Andy0122/CE1107-Cerrojo-Logico/docs/Proyecto_FAC_Paper.pdf

INSTITUTO TECNOLOGICO DE COSTA RICA, CE 1107: FUNDAMENTOS DE ARQUITECTURA DE COMPUTADORES, SEPTIEMBRE 2026 | 1 ´
Diseno, Optimizaci ˜ | on e Implementaci ´ | on F ´ | ísica de

# un Cerrojo Digital en Base 5 con Disciplina

Estatica TTL y Desacople Galv ´ | anico ´

Juan Pablo Araya Rodríguez y Dylan Elizondo Picado

Resumen—This paper presents the design, algebraic minimization, and physical implementation of an electronic door locking system governed by three-digit base-5 passwords. The input interface acquires data through a four-finger photoresistor array conditioned by Schmitt-trigger inverters to suppress analog noise, followed by an optimized XOR parity and combinational encoding network yielding a three-bit binary representation. Data transmission adheres to a strict single-wire serial constraint achieved via a multiplexer driven by a synchronous modulo-3 counter. The receiving stage utilizes cascaded serial-in parallel-out shift registers to reconstruct the complete nine-bit parallel vector, alongside a secondary counter that asserts a completion flag. The combinational core validates the assigned passwords for opening and closing operations by applying De Morgan’s theorem to extract common literals, entirely eliminating discrete inverters. State retention is commanded by a discrete NOR-based SR latch, while status feedback is broadcast on a seven-segment display using intermediate one-hot decoding to render distinct operational characters. Furthermore, complete galvanic decoupling is realized through optical isolators driving an H-bridge motor controller with normally closed limit switches, preventing inductive transients from disturbing the TTL static discipline. Experimental evaluation validates deterministic switching, zero spurious latch transitions, and consistent mechanical actuation.

Index Terms—Circuitos combinacionales, logica secuencial, disciplina est ´ | atica TTL, desacople galv ´ | anico, Teorema de De Morgan. ´

✦

### 1. INTRODUCCION´

E
L diseno de sistemas de seguridad basados en l ˜ | ogica ´
digital discreta representa un pilar fundamental en la comprension de la arquitectura de computadores, per- ´ mitiendo la confluencia entre la síntesis combinatoria, la
sincronizacion secuencial y la interacci ´ | on con transductores ´
electromecanicos [1]. Tradicionalmente, los mecanismos de ´ autenticacion num ´ erica se conciben en esquemas decimales o ´ hexadecimales acoplados a microcontroladores; no obstante, el diseno estructurado a nivel de circuitos integrados de baja ˜
escala de integracion (SSI) y media escala de integraci ´ | on´
(MSI) demanda un analisis riguroso de la disciplina est ´ | atica, ´
retardos de propagacion y consumo de ´ | area en silicio [2], [4]. ´
El presente artículo documenta el desarrollo integral
de una cerradura electronica gobernada por contrase ´ | nas ˜
de tres dígitos en base 5 (0 . . . 4), ingresadas manualmente mediante el conteo de dedos extendidos. La especificacion´
tecnica establece restricciones de dise ´ | no cr ˜ | íticas: la interfaz
entre el bloque sensorial y el procesamiento digital debe ser
estrictamente serial (un unico conductor f ´ | ísico), el procesa-
miento combinatorio debe implementarse exclusivamente mediante circuitos integrados de compuertas logicas bajo ´
una unica familia tecnol ´ | ogica, y la etapa motriz debe aislarse ´
electricamente del n ´ | ucleo l ´ | ogico mediante componentes ´
discretos.
El objetivo central radica en sintetizar una arquitectura determinista que optimice el conteo de compuertas mediante

Los autores son estudiantes de la Escuela de Ingeniería en Computadores del Instituto Tecnológico de Costa Rica (TEC), Cartago, Costa Rica (emails: ju.araya@estudiantec.cr, delizondo@estudiantec.cr). Curso: CE 1107 — Fundamentos de Arquitectura de Computadores, II Semestre 2026. Profesor: Luis Chavarría Zamora.

tecnicas formales de reducci ´ | on booleana, erradique estados ´
indeterminados en la memoria de retencion y desacople ´ galvanicamente los transitorios de potencia generados por el ´ actuador de corriente directa.
El resto de este artículo se organiza de la siguiente manera: la Seccion II analiza los fundamentos de la disciplina ´
estatica bajo la uniformidad tecnol ´ | ogica TTL; la Secci ´ | on´
III detalla la metodología, el algoritmo de diseno modular ˜
y la reduccion de contrase ´ | nas; la Secci ˜ | on IV describe la ´
etapa de desacople de potencia y control de movimiento; la Seccion V expone los resultados experimentales y la ´ discusion de laboratorio; y las Secciones VI y VII presentan ´ las conclusiones y recomendaciones en prosa.
2. DISCIPLINA ESTATICA Y ´ | UNIFORMIDAD TEC-
NOLOGICA ´ | TTL
La disciplina estatica garantiza que una red l ´ | ogica man- ´
tenga una interpretacion inequ ´ | ívoca de los niveles booleanos
(0 y 1) en presencia de atenuaciones y perturbaciones de ruido, definiendo bandas de voltaje prohibidas entre las tensiones de entrada y salida [3].
2.1. Niveles Logicos y M ´ | argenes de Ruido ´
Para la familia TTL estandar (serie 74LS alimentada a ´ VCC = 5,0 V), los umbrales de conmutacion nominales ´ corresponden a:
VOH(mín) = 2,7 V, | VOL(máx) = 0,4 V | (1)
VIH(mín) = 2,0 V, | VIL(máx) = 0,8 V | (2)

INSTITUTO TECNOLOGICO DE COSTA RICA, CE 1107: FUNDAMENTOS DE ARQUITECTURA DE COMPUTADORES, SEPTIEMBRE 2026 | 2 ´
Esto define un margen de ruido en alto de NMH | =
VOH(mín) − VIH(mín) = 0,7 V y un margen en bajo de

NML = VIL(máx) − VOL(máx) = 0,4 V.
Para preservar estos margenes y evitar zonas de inde- ´
terminacion el ´ | ectrica, el proyecto adopt ´ | o una ´ | estricta uni-
formidad tecnol ógica, empleando exclusivamente circuitos integrados de la familia bipolar TTL Schottky (74LS) en todo el sistema digital, descartando la interconexion con ´ tecnologías heterogeneas. ´

### 3. ARQUITECTURA DEL SISTEMA Y ALGORITMO DE

DISENÕ
El sistema opera mediante una secuencia estructurada de
adquisicion, conversi ´ | on, transporte y validaci ´ | on, dividida en ´
cinco submodulos coordinados. ´

### 3.1. Modulo 1: Captura Sensorial y Codificador Combi- ´

natorio
El registro de los dedos se efectua mediante cuatro fotore- ´ sistencias (L3, L2, L1, L0) en divisor de tension con resisten- ´ cias pull-up de 10 kΩ. Dado que la transicion anal ´ ogica de luz ´ a sombra introduce retardos variables y ruido, se intercalo un ´ integrado inversor Schmitt Trigger ‘74LS14‘, cuya histeresis ´ interna regenera ondas cuadradas ideales de 0 V a 5 V. Cuatro LEDs indicadores proporcionan retroalimentacion visual en ´ paralelo.
Al asumir una colocacion termom ´ | etrica de los dedos ( ´ | 0 a
4), las 16 combinaciones teoricas se reducen a 5 estados v ´ | ali- ´
dos; los 11 estados restantes se modelaron como condiciones de no importa (X). Mediante analisis en Mapas de Karnaugh ´ de 4 variables:
Bit mas significativo ( ´ | D2): Activo solo en 4 dedos
(m15). Se sintetiza como D2 = L0 · L1 · L2 · L3 con una compuerta AND (‘74LS21‘).
Bit medio (D1): Activo en 2 y 3 dedos. Su lazo mínimo resulta en D1 = L1 · L3, implementado con un inversor y una compuerta AND (‘74LS08‘).
Bit menos significativo (D0): Activo en 1 y 3 dedos. Presenta un comportamiento de paridad impar, sintetizado elegantemente mediante un arbol de tres ´ compuertas XOR (‘74LS86‘):
D0 = (L0 ⊕ L1) ⊕ (L2 ⊕ L3) | (3)

### 3.2. Modulo 2: Serializador con CI TTL 74153 y Contador ´

Modulo-3 ´
Para canalizar el vector paralelo (D2D1D0) a traves´
de un unico canal serial, se implement ´ | | o un multiplexor ´
‘74LS153‘ [5]. Sus canales 1C0, 1C1, 1C2 reciben los bits de datos, mientras que 1C3 y el estrobo activo en bajo (1G) se derivaron a tierra permanente.
La seleccion de canal es gobernada por un contador ´ síncrono de dos bits (Q1Q0) truncado a ciclo modulo-3 ´ (00 → 01 → 10 → 00), construido con dos flip-flops tipo D (‘74LS74‘), una compuerta NOR y una compuerta AND:
| D0 = Q1 + Q0, | D1 = Q0 · Q1 | (4)

Al alcanzar el estado 10, una red combinatoria emite la bandera de acarreo ‘F inDigito‘.

3.3. Modulo 3: Reconstrucci ´ | | | | on Serial-Paralelo y Bande- ´
ra ‘Listo‘
En el receptor, la línea serial ingresa a dos registros de desplazamiento de 8 bits SIPO ‘74LS164‘ conectados en cascada [6]: la salida QH del primer chip alimenta la entrada serie del segundo, conformando un registro continuo de 9 bits (P8 . . . P0).
Un segundo contador modulo-3 independiente (‘74LS74‘), ´ excitado por la senal ‘ ˜ F inDigito‘, contabiliza los 3 dígitos transmitidos (3 × 3 = 9 pulsos). Al completarse la trama, conmuta la bandera de control Listo = 1, congelando el registro y habilitando la etapa de discriminacion de claves. ´
3.4. Modulo 4: Núcleo Combinatorio y Evaluaci ´ | on de ´
Contrasenas ˜
Las contrasenas no triviales asignadas al sistema corres- ˜
ponden a la combinacion de apertura ´ | 4135 y la de cierre 1425.
Al expresar ambos codigos en su representaci ´ | on binaria de ´
nueve bits (P8 . . . P0) estructurada a partir del vector serial reconstituido, se obtiene el siguiente desglose posicional:

Tabla 1
Identificacion posicional de literales comunes para contrase ´ | nas ˜
Operacion | Valor ´ | P8 | P7 | P6 | P5 | P4 | P3 | P2 | P1 | P0
Apertura | 4135 | 0 | 1 | 1 | 0 | 0 | 1 | 1 | 0 | 0
Cierre | 1425 | 0 | 1 | 0 | 1 | 0 | 0 | 0 | 0 | 1

A partir de la Tabla 1, las funciones canonicas iniciales ´
que evaluan la coincidencia estricta de cada contrase ´ | na se ˜
definen inicialmente de forma disgregada como:
Abririni = P8 · P7 · P6 · P5 · P4 · P3 · P2 · P1 · P0 | (5)
Cerrarini = P8 · P7 · P6 · P5 · P4 · P3 · P2 · P1 · P0 | (6)
Para optimizar los recursos logicos y evitar la duplicaci ´ | on´
de compuertas, se observa que ambas expresiones comparten
un patron com ´ | un en las posiciones ´ | P8, P7, P4 y P1. Extrayen-
do algebraicamente dicho factor comun´ COMUN, se agrupan los literales de la siguiente manera:
COMUN = P8 · P7 · P4 · P1 | (7)

Aplicando formalmente el Teorema de De Morgan sobre las variables negadas que componen este termino: ´

P8 · P4 · P1 = P8 + P4 + P1 | (8)

Esta identidad permite sintetizar el bloque compartido empleando una compuerta NOR de tres entradas (‘74LS27‘) conectada en cascada con una compuerta AND (‘74LS08‘), cuya expresion final optimizada corresponde a: ´
COMUN = (P8 + P4 + P1) · P7 | (9)

Finalmente, factorizando este termino compartido, las ´ ecuaciones mínimas que gobiernan las salidas de evaluacion´ del nucleo combinatorio se estructuran como: ´
Abrir = COMUN · (P6 · P5 · P3 · P2 · P0) | (10)
Cerrar = COMUN · (P6 · P5 · P3 · P2 · P0) | (11)

Este enfoque de diseno modular y factorizado absorbe ˜ los estados complementados dentro de compuertas NOR comerciales, erradicando por completo la necesidad de inversores discretos adicionales en el decodificador de claves.

INSTITUTO TECNOLOGICO DE COSTA RICA, CE 1107: FUNDAMENTOS DE ARQUITECTURA DE COMPUTADORES, SEPTIEMBRE 2026 | 3 ´

Tabla 2
Mapeo Logico de Segmentos para Visualizador de Anuncios ´
Estado | Caracter | Listo ´ | SA | SC | SE | a | b, c | d | g
Leyendo | L | 0 | 0 | 0 | 0 | 0 | 0 | 1 | 0
Abierta | A | 1 | 1 | 0 | 0 | 1 | 1 | 0 | 1
Cerrada | C | 1 | 0 | 1 | 0 | 1 | 0 | 1 | 0
Error | E | 1 | 0 | 0 | 1 | 1 | 0 | 1 | 1

### 3.5. Modulo 5: Memoria de Estado y Decodificador de ´

Anuncios
Las líneas discriminadas excitan un biestable Latch SR construido con dos compuertas NOR cruzadas (‘74LS02‘):
Qt+1 = R + Qt, | Qt+1 = S + Qt | (12)

Dado que las claves son mutuamente excluyentes, la condi-
cion cr ´ | ítica indeterminada (S = 1, R = 1) queda eliminada
matematicamente por dise ´ | no. ˜
El visualizador de 7 segmentos (catodo com ´ | un) despliega ´
el estado del cerrojo. Para optimizar la síntesis, se generaron tres estados intermedios en codigo *one-hot*: ´
SA = Abrir · Listo | (13)
SC = Cerrar · Listo | (14)
SE = (Abrir + Cerrar) · Listo | (15)

El mapeo de segmentos resultante se presenta en la Tabla 2. Los segmentos e y f permanecen conectados estaticamente ´ a VCC (constante 1), mientras que los segmentos restantes se deducen como: b = c = SA, d = SA, g = SA + SE y a = SA + SC + SE, empleando compuertas OR (‘74LS32‘) y una compuerta NOT (‘74LS04‘).

4. ETAPA DE DESACOPLE GALVANICO Y ´ | ACTUA-

DOR
Para satisfacer el requerimiento de aislar electricamente el ´
circuito logico del mecanismo electromec ´ | anico, se dise ´ | nõ una ´
etapa de potencia basada en optoacopladores y un puente H.

### 4.1. Aislamiento Optico mediante PC817 ´

Se interconectaron dos optoacopladores ‘PC817‘ entre la logica digital y el driver del motor. Las salidas del Latch ´ (Q y Q) excitan los diodos emisores infrarrojos a traves´ de resistencias de 330 Ω, demandando una corriente de
polarizacion segura de ´ | IF ≈ 11,5 mA. Los fototransistores
receptores operan acoplados al dominio de una batería externa de 9 V, garantizando independencia absoluta entre las tierras GND5V y GND9V .

### 4.2. Driver L9110S y Logica Activa en Bajo ´

El accionador consiste en un motorreductor de CD comandado por un puente H ‘L9110S‘. Las entradas de
control del modulo operan bajo l ´ | ogica activa en bajo (Active ´
LOW) debido a resistencias internas de elevacion hacia ´ | 9 V.
Los fototransistores de los optoacopladores conmutan a tierra de potencia (GND9V ):
Reposo: Ambas entradas a 9 V → Motor en freno estatico. ´

Apertura: Entrada A-1A a 0 V → Giro en sentido directo.
Cierre: Entrada A-1B a 0 V → Giro en sentido inverso.

### 4.3. Control de Fin de Recorrido mediante Contactos

NC

En los extremos mecanicos de la puerta se fijaron dos ´ microswitches de palanca (F CA y F CC ). Los terminales comun (‘COM‘) y normalmente cerrado (‘NC‘) se intercalaron ´ directamente en serie con la alimentacion del LED del ´ optoacoplador respectivo. Al impactar el tope físico, la
palanca abre el contacto mecanico, extinguiendo la radiaci ´ | on´
optica y desactivando el puente H en menos de ´ | 5 ms. La
alta friccion est ´ | atica interna del tren de engranes impide el ´
retroceso mecanico de la maqueta, eliminando oscilaciones ´ erroneas sin requerir circuitos biestables adicionales. ´

### 5. RESULTADOS EXPERIMENTALES Y DISCUSION´

El prototipo se implemento en protoboards totalizando ´ 15 circuitos integrados TTL de la serie 74LS, interconectados a una maqueta de puerta a escala.

5.1. Inmunidad y Validacion de Contrase ´ | nas ˜

Se aplico un banco de pruebas exhaustivo evaluando com- ´ binaciones nominales y vectores con distancia de Hamming igual a 1 bit respecto a las claves verdaderas (Tabla 3). En todos los casos de clave incorrecta o vectores degenerados (nulo o saturado), el sistema rechazo el ingreso de manera ´ determinista, activando el caracter ‘E‘ en el display sin alterar ´ el estado previo del Latch SR.

### 5.2. Filtrado Antirrebote y Desacoplo de Ruido

Durante las pruebas preliminares, los pulsadores manuales de reloj manifestaron transitorios mecanicos de conmuta- ´
cion (bounce), provocando saltos an ´ | omalos en los contadores ´
‘74LS74‘. La insercion de condensadores RC ( ´ | 10 kΩ y 10 µF,
τ = 100 ms) elimino completamente las falsas transiciones. ´
Asimismo, la segregacion galv ´ | anica mediante los op- ´
toacopladores ‘PC817‘ demostro una efectividad cr ´ | ítica,
comprobando que las corrientes inductivas de retorno fueron confinadas íntegramente en la batería de 9 V.

Tabla 3
Resultados de Validacion de Vectores de Entrada ´
Descripcion del Vector | Entrada ( ´ | P8 . . . P0) | Abrir | Cerrar | Display
Apertura Valida ( ´ | 4135) | 011001100 | 1 | 0 | A
Cierre Valido ( ´ | 1425) | 010100001 | 0 | 1 | C
Vector Nulo | 000000000 | 0 | 0 | E
Vector Saturado | 111111111 | 0 | 0 | E
Error 1 bit en Apertura | 011001101 | 0 | 0 | E
Error 1 bit en Cierre | 010100000 | 0 | 0 | E

INSTITUTO TECNOLOGICO DE COSTA RICA, CE 1107: FUNDAMENTOS DE ARQUITECTURA DE COMPUTADORES, SEPTIEMBRE 2026 | 4 ´

### 6. CONCLUSIONES

El diseno e implementaci ˜ | on del cerrojo digital en base 5 ´
demostro la viabilidad de sintetizar sistemas de autenticaci ´ | | on´
robustos empleando exclusivamente logica cableada discreta ´ y circuitos integrados estandar de la familia TTL Schottky. La ´ descomposicion modular de la interfaz serial, materializada ´ mediante el multiplexor 74LS153 y contadores síncronos
de dos bits, permitio superar con ´ | exito la restricci ´ | on de ´
canal unico de comunicaci ´ | on, reconstruyendo de forma ´
determinista el bus paralelo de nueve variables a traves´ de registros de desplazamiento en cascada.
La aplicacion sistem ´ | atica del Teorema de De Morgan en el ´
decodificador de contrasenas evidenci ˜ | o ser una estrategia de ´
optimizacion sumamente eficaz, posibilitando la extracci ´ | | on´
de un termino com ´ | un para las claves de apertura y cierre y ´
la absorcion de los estados complementados dentro de com- ´ puertas NOR comerciales, lo cual erradico por completo la ´ necesidad de inversores discretos en dicha etapa. Asimismo,
la estructuracion de variables intermedias bajo codificaci ´ | | on´
one-hot desacoplo la complejidad anal ´ | ítica del visualizador
de anuncios, minimizando el conteo de compuertas y permi-
tiendo polarizar estaticamente dos segmentos a la l ´ | | ínea de
alimentacion. ´
Finalmente, la integracion de una etapa de desacople ´ galvanico fundamentada en optoacopladores y el aprove- ´ chamiento de los contactos normalmente cerrados de los finales de carrera demostraron ser determinantes para la
estabilidad electromecanica. Esta arquitectura no solo aisl ´ | | ó
las perturbaciones inductivas y rebotes de tierra propios del
motorreductor preservando la disciplina estatica del n ´ | ucleo ´
digital, sino que garantizo una detenci ´ | on f ´ | ísica inmediata de
la puerta sin requerir memorias secuenciales auxiliares.

### 7. RECOMENDACIONES

Para desarrollos futuros y extensiones industriales de este proyecto, se aconseja incorporar redes de disparo Schmitt Trigger integradas directamente en cada una de las líneas de reloj y reinicio maestro, sustituyendo los filtros RC pasivos por conformadores de pulso activos con el proposito de ´ optimizar los tiempos de subida y bajada ante frecuencias de conmutacion m ´ as elevadas. ´
Asimismo, se recomienda sustituir el modulo de fotore- ´ sistencias dependiente de la luz ambiental por transductores opticos infrarrojos de barrera ranurada o interruptores ´ capacitivos blindados, lo cual reduciría la necesidad de cali-
bracion resistiva y asegurar ´ | | ía un funcionamiento uniforme
bajo cualquier condicion de iluminaci ´ | on en el entorno de ´
operacion. ´
En lo concerniente al montaje físico de alta densidad en protoboard, se sugiere tender pistas de desacople de alimenta-
cion malladas acompa ´ | nadas de condensadores cer ˜ | amicos de ´
cien nanofaradios soldados directamente entre los terminales de polarizacion de cada circuito integrado, mitigando induc- ´
tancias parasitas asociadas a conductores a ´ | ereos extensos. ´
Por ultimo, resulta altamente conveniente dotar a la maqueta ´ de un embrague mecanico o fusible rearmable en serie con el ´ motor, salvaguardando la integridad del tren reductor ante eventuales fallas mecanicas en los microswitches de fin de ´ recorrido.

REFERENCIAS

[1] M. M. Mano y M. D. Ciletti, Digital Design: With an Introduction to the Verilog HDL, 5th ed. Boston, MA, USA: Pearson, 2013.
[2] S. L. Harris y D. Harris, Digital Design and Computer Architecture: ARM Edition. Cambridge, MA, USA: Morgan Kaufmann, 2022.
[3] T. L. Floyd, Fundamentos de Sistemas Digitales, 11th ed. Madrid,
Espana: Pearson Educaci ˜ | on, 2015. ´
[4] R. J. Tocci, N. S. Widmer, y G. L. Moss, Sistemas Digitales: Principios y Aplicaciones, 12th ed. Mexico: Pearson, 2017. ´
[5] Texas Instruments, SN74LS153 Dual 4-Line to 1-Line Data Selectors/Multiplexers Datasheet, Dallas, TX, USA, 2018.
[6] Texas Instruments, SN74LS164 8-Bit Parallel-Out Serial Shift Registers Datasheet, Dallas, TX, USA, 2020.
