Andy0122/CE1107-Cerrojo-Logico/docs/Bitácora_Proyecto_FAC.pdf

## Instituto Tecnológico de Costa Rica

Escuela de Ingeniería en Computadores CE 1107 Fundamentos de Arquitectura de Computadores

## Bitácora del Cerrojo Digital TTL

Diseño, Reducción Booleana, Módulos en Cascada, Aislamiento y Pruebas Experimentales

Estudiantes:
Juan Pablo Araya Rodríguez Dylan Elizondo Picado
Profesor: Luis Chavarría Zamora

Septiembre de 2026

### 1. Introducción y Alcance del Proyecto

La presente bitácora documenta de manera formal el desarrollo integral del sistema de cerrojo digital basado en lógica combinacional y secuencial TTL. El proyecto abarca desde la captura sensorial de la contraseña en base 5, pasando por el diseño de bloques en cascada, la reducción booleana por el teorema de De Morgan, hasta el control de potencia de un motor de corriente directa con aislamiento galvánico y visualización avanzada.

### 2. Arquitectura del Sistema y Conexión en Cascada

El flujo general de control se compone de módulos interconectados que procesan los estados de entrada y retención.

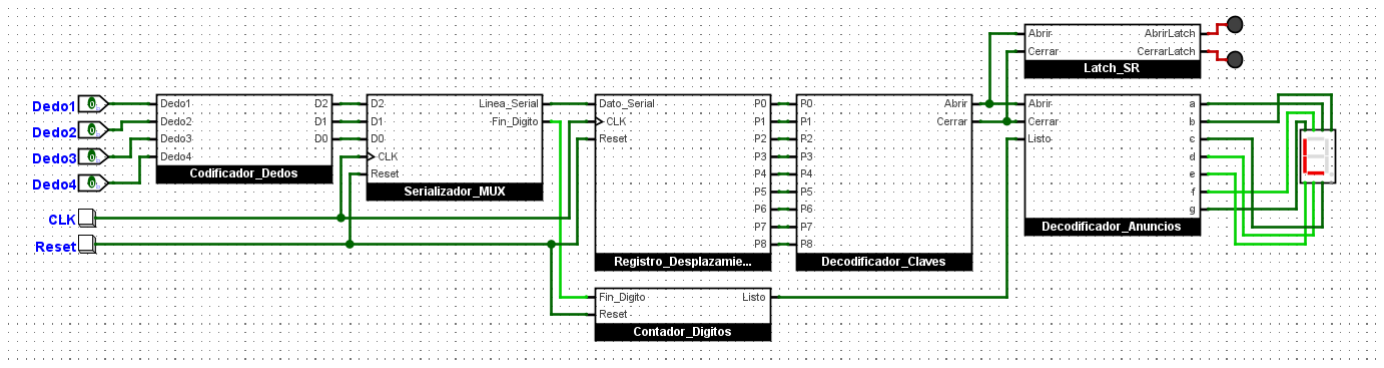
[picture p1: figure]

Figura 1: Diagrama de bloques y conexionado en cascada.

El Módulo 1 recibe los 9 bits estáticos (P8 . . . P0) correspondientes a la contraseña y genera las señales discriminadas Abrir y Cerrar. Estas alimentan en cascada al Módulo 2 (Latch de retención) y convergen junto con la señal de control Listo en el decodificador del visualizador.

### 3. Día 1 (18 de septiembre de 2026): Captura Sensorial y Codificación a Base 5

### 3.1. Modelo Sensorial

La contraseña se captura mediante una matriz de 4 fotoresistencias (LDRs, L0 . . . L3) dispuestas en divisores de tensión con resistencias pull-up de 10 kΩ. El conteo manual de dedos (0 a 4) presenta una naturaleza acumulativa. Se incorporaron LEDs con resistencias de 330 Ω para la validación visual de la postura de la mano.

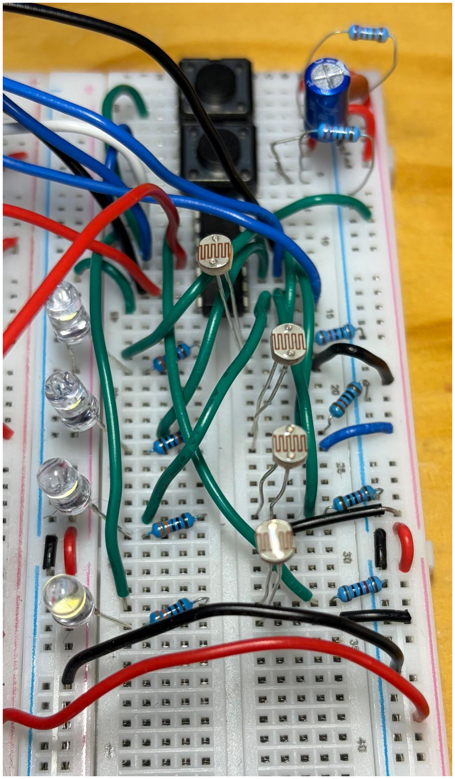
[picture p2: figure]

Figura 2: Circuito de LDRs.

### 3.2. Mapeo Sensorial y Deducción Algebraica

La traducción del vector sensorial (L3L2L1L0) al código binario natural (D2D1D0) se estructuró conforme a la Tabla 1. Las claves asignadas al sistema son:

Apertura (413 5): Dígito 4 (100), Dígito 1 (001), Dígito 3 (011) ⇒ 011 001 1002.

Cierre (142 5): Dígito 1 (001), Dígito 4 (100), Dígito 2 (010) ⇒ 010 100 0012.

Dedos | Estado LDR (L 3L 2L 1L 0) Decimal | Binario (D 2D 1D 0)
0 dedos | 0000 | 0 | 00 | 0
1 dedo | 0001 | 1 | 00 | 1
2 dedos | 0011 | 2 | 01 | 0
3 dedos | 0111 | 3 | 01 | 1
4 dedos | 1111 | 4 | 10 | 0

Tabla 1: Tabla de verdad del mapeo sensorial y codificación a 3 bits.

Las funciones lógicas del mapeo se dedujeron algebraicamente de la siguiente manera:

Bit Menos Significativo (D 0): Arbol de tres compuertas XOR (‘74LS86‘) como detector de ´ paridad impar: D0 = (L0 ⊕ L1) ⊕ (L2 ⊕ L3).

Bit Medio (D 1): Inhibición por L3 sobre L1: D1 = L1 · L3 (1 inversor ‘74LS04‘ y 1 compuerta AND ‘74LS08‘).

Bit Más Significativo (D 2): Conjunción total para el valor 4: D2 = L0 · L1 · L2 · L3 mediante compuerta AND de 4 entradas (‘74LS21‘).

### 4. Día 2 (19 de septiembre de 2026): Interfaz Serial, MUX 74153 y Contador Módulo-3

### 4.1. Multiplexación Serial y Contador Síncrono

Para convertir los 3 bits paralelos del dígito (D2D1D0) a un canal serial, se implementó el circuito integrado TTL ‘74LS153‘ (Doble MUX de 4 a 1 líneas). El Pin 1 (1G) se conectó a GND y el Pin 3 (1C3) a GND para evitar entradas flotantes. El indexador se construyó mediante un contador síncrono con dos flip-flops tipo D (‘74LS74‘), recorriendo la secuencia 00 → 01 → 10 → 00. Sus ecuaciones de realimentación son:

D0 = Q1 + Q2 (puerta NOR), | D1 = Q0 · Q1 (puerta AND) | (1)

garantizando auto-recuperación ante transitorios en el estado ilegal ‘11‘.

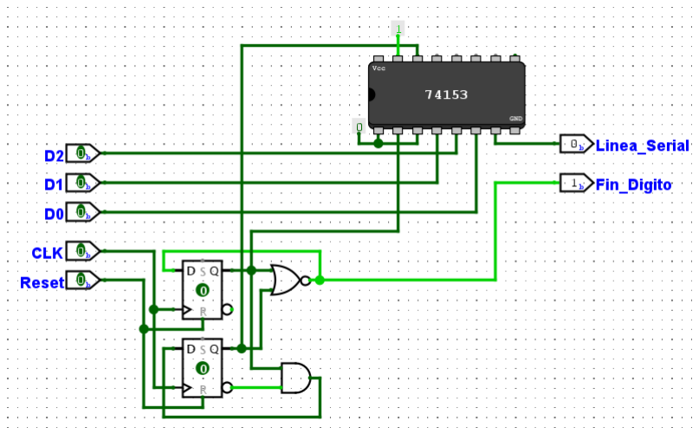
[picture p3: figure]

Figura 3: Diagrama esquemático del multiplexor 74LS153 y contador síncrono de control.

### 5. Día 3 (21 de septiembre de 2026): Registro SIPO de 9 Bits y Unidad de Control

### 5.1. Almacenamiento y Generación de Bandera

Los tres dígitos ingresados secuencialmente se almacenan en una cadena de registros de desplazamiento de entrada serial y salida paralela (SIPO) de 9 bits (P8 . . . P0). Un segundo contador módulo-3 incrementa su cuenta al finalizar cada dígito completo hasta activar la señal de control:

Listo = 1 | (2)

la cual notifica al decodificador de anuncios el fin de la lectura.

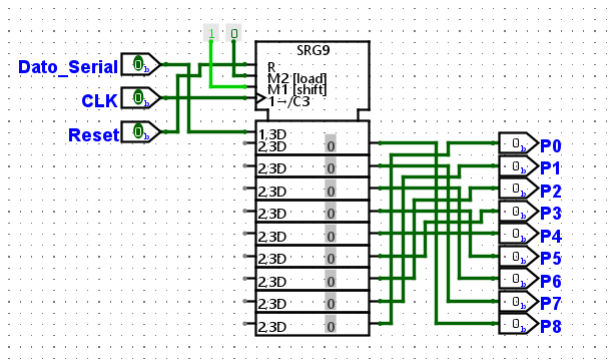
[picture p4: figure]

Figura 4: Implementación del registro SIPO de 9 bits.

### 6. Día 4 (23 de septiembre de 2026): Optimización Booleana y Desacople Galvánico

### 6.1. Reducción por Teorema de De Morgan

Las funciones lógicas canónicas del comparador requerirían dos redes independientes de 9 variables:

Abrir = P8 · P7 · P6 · P5 · P4 · P3 · P2 · P1 · P0 | (3)
Cerrar = P8 · P7 · P6 · P5 · P4 · P3 · P2 · P1 · P0 | (4)

Comparando el vector de apertura y el de cierre se extrajo el factor común:

COMUN = P8 · P7 · P4 · P1 = P8 + P4 + P1 · P7 | (5)

implementado con una compuerta NOR de 3 entradas (‘74LS27‘) y una AND (‘74LS08‘). Aplicando sistemáticamente el teorema de De Morgan, se eliminaron en su totalidad los 11 inversores requeridos por la forma canónica. Las expresiones mínimas quedan definidas como:

Abrir = COMUN · (P6 · P5 · P3 · P2 · P0) | (6)
Cerrar = COMUN · (P6 · P5 · P3 · P2 · P0) | (7)

### 6.2. Aislamiento Galvánico y Potencia

Para proteger los circuitos TTL (IOH ≈ 0,4 mA) del consumo transitorio del motor de CD (150 − 400 mA), se implementó aislamiento óptico con optoacopladores ‘PC817‘. La resistencia limitadora del LED emisor se fijó en 330 Ω (IF ≈ 11,51 mA). Las entradas del puente H ‘L9110S‘ se controlaron mediante los fototransistores en configuración pull-down directo.

### 6.3. Decodificador de Anuncios y Estados Intermedios

Para el display de 7 segmentos, se definieron tres variables de estado intermedio tipo one-hot (SA, SC, SE):

SA = Listo · Abrir · Cerrar | (8)
SC = Listo · Abrir · Cerrar | (9)
SE = Listo · Abrir + Cerrar | (10)

Reduciendo las funciones de segmentos, se obtiene que e = 1 (VDD) y f = 1 (VDD) de forma directa.

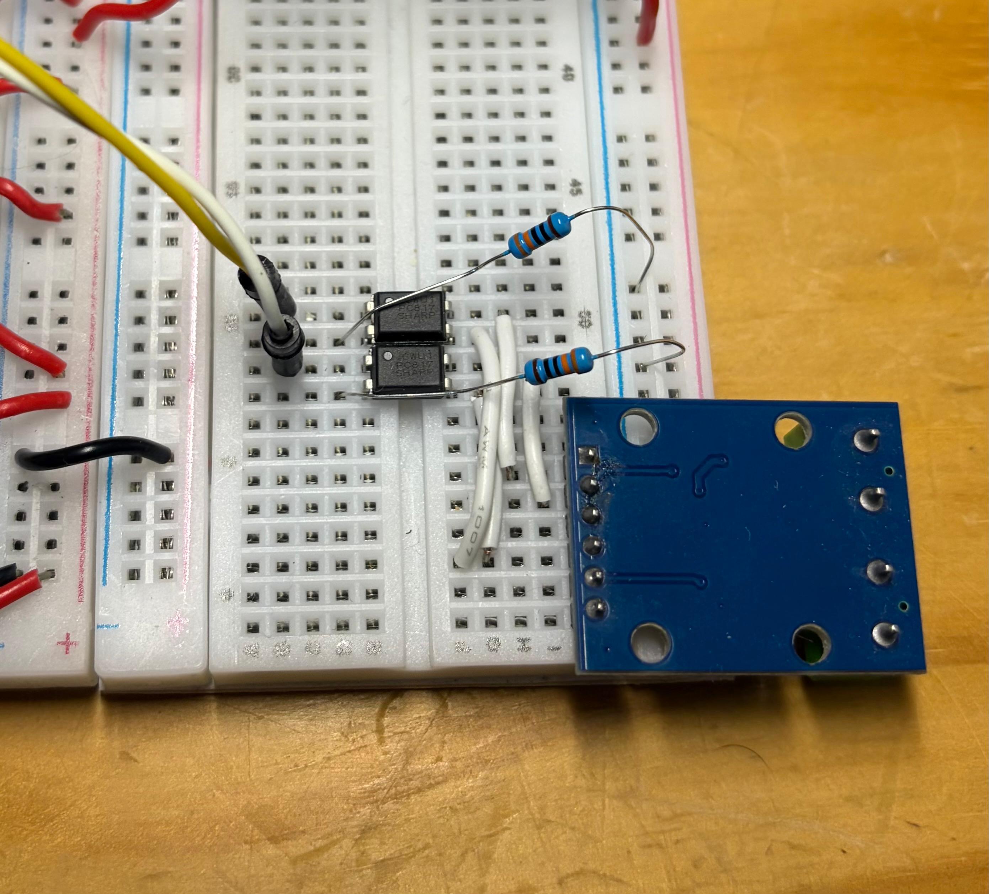
[picture p5: figure]

Figura 5: Circuito de aislamiento galvánico con optoacopladores y puente H.

### 7. Día 5 (25 de septiembre de 2026): Finales de Carrera y Pruebas Experimentales

### 7.1. Integración Electromecánica

Se intercalaron microswitches en configuración NC (Normalmente Cerrada) en serie con las líneas de los optoacopladores para cortar instantáneamente el motor al impactar los topes físicos F CA y F CC. Asimismo, se instaló un filtro antirrebote RC (R = 10 kΩ, C = 10 µF, τ = 100 ms) en los pulsadores de reloj y reset.

### 7.2. Validación Experimental y Pruebas en Cascada

Se evaluó el sistema completo frente a vectores válidos, nulos, saturados y errores de 1 bit (distancia
de Hamming), confirmando la robustez del diseño.
Condición de Prueba | Entrada (P 8 . . . P 0) Listo | Abrir | Cerrar | Display | Resultado Observado
Clave Apertura Válida | 011001100 | 1 | 1 | 0 | A | Apertura exitosa
Clave Cierre Válida | 010100001 | 1 | 0 | 1 | C | Cierre exitoso
Vector Nulo | 000000000 | 1 | 0 | 0 | E | Rechazo (Inválida)
Error de 1 bit | 011001101 | 1 | 0 | 0 | E | Rechazo absoluto

Tabla 2: Protocolo de pruebas experimentales integradas del sistema.

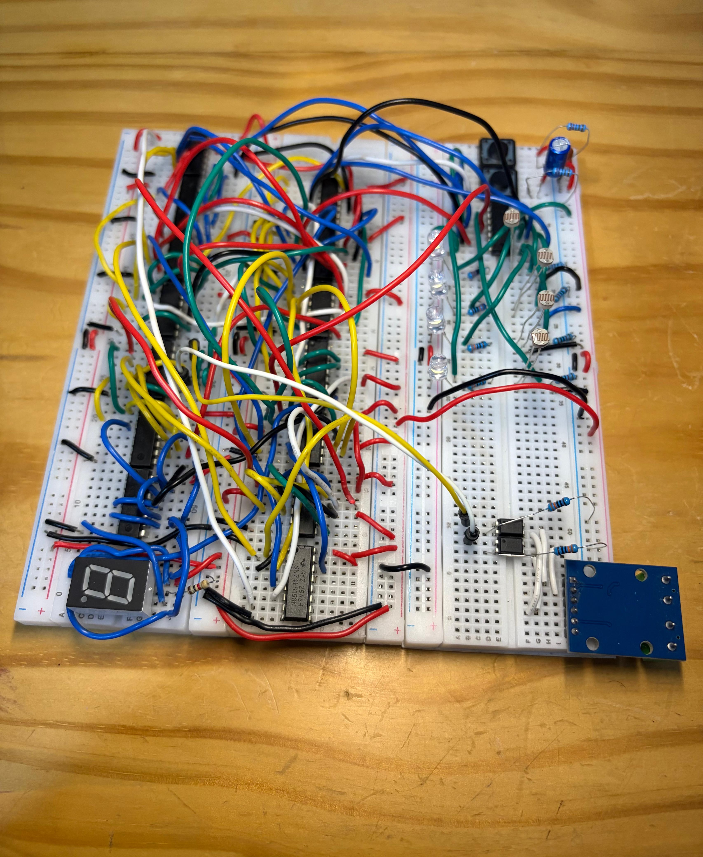
[picture p6: figure]

Figura 6: Montaje final integrado en protoboard.

### 8. Conclusiones

1. La extracción algebraica del término común mediante De Morgan optimizó sustancialmente la red combinacional del comparador de contraseñas.
2. La exclusión de la condición indeterminada (S = 1, R = 1) en el Latch SR se garantizó de forma natural debido a la mutua exclusión de las claves en base 5.
3. El uso de optoacopladores ‘PC817‘ previno eficazmente el ruido inductivo (ground bounce) generado por la conmutación del motor de corriente directa.
4. El seguimiento riguroso de las 5 sesiones de trabajo aseguró una implementación modular y verifi-cable tanto por bloques independientes como en cascada en protoboard.

### 9. Enlace al Repositorio de GitHub

El código fuente de los diagramas de Logisim Evolution, simulaciones y la documentación completa en LaTeX se encuentran disponibles de manera pública en el repositorio oficial del proyecto:

https://github.com/Andy0122/CE1107-Cerrojo-Logico
