Andy0122/CE1107-Cerrojo-Logico/docs/Bitacora_Taller_Semana5.pdf

## Instituto Tecnológico de Costa Rica

Escuela de Ingeniería en Computadores CE 1107 — Fundamentos de Arquitectura de Computadores

## Bitácora de Diseño: Sesión Asincrónica Semana 5

Implementación y Reducción de Etapas Combinacionales y Secuenciales (Prueba Estática)

Estudiantes:
Juan Pablo Araya Rodríguez Dylan Elizondo Picado
Profesor: Luis Chavarría Zamora

17 de septiembre de 2026

### 1. Objetivo y Alcance del Taller

El objetivo de esta sesión práctica es diseñar, simplificar algebraicamente e implementar mediante compuertas lógicas dos etapas fundamentales del sistema de seguridad:

1. Módulo de Contraseñas: Ingreso estático mediante interruptores de una clave en base 5 y visua-lización de estados en un display de siete segmentos.
2. Decodificador de Apertura y Cierre: Conectado en cascada desde las salidas del módulo anterior para comandar la memoria de estado de la puerta.

Para cumplir con la directriz de evaluación aislada, la presente bitácora documenta el diseño, la reducción booleana y la verificación experimental de cada bloque de forma independiente antes de su interconexión definitiva.
—

### 2. Arquitectura del Sistema y Conexión en Cascada

La Figura 1 describe el flujo de señales. El Módulo 1 recibe los 9 bits estáticos (P8 . . . P0) correspon-dientes a la contraseña y genera las señales discriminadas Abrir y Cerrar. Estas alimentan en cascada al Módulo 2 (Latch de retención) y convergen junto con la señal de control Listo en el decodificador del

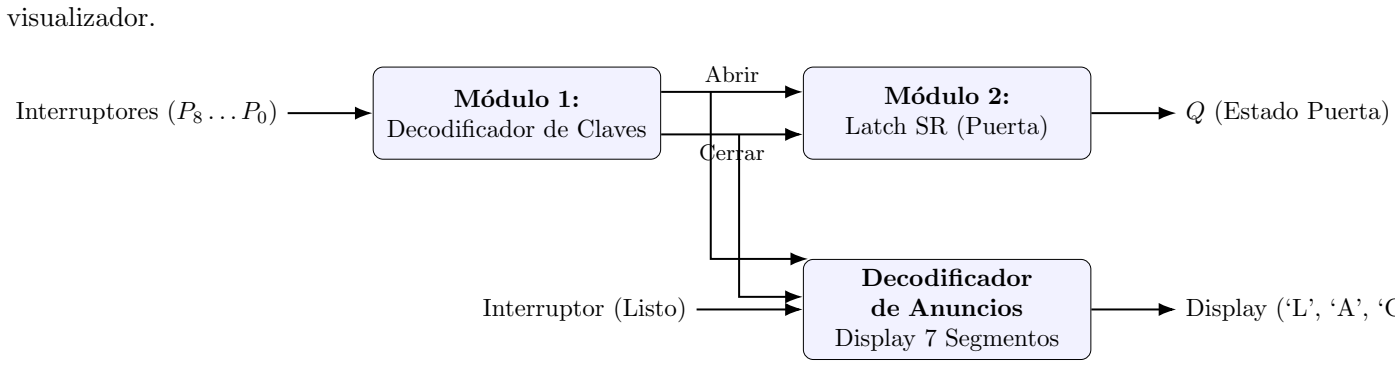
[picture p7: figure]
visualizador.; Interruptores (P8 . . . P0); Módulo 1:; Decodificador de Claves; Módulo 2: Latch SR (Puerta); Decodificador de Anuncios Display 7 Segmentos; Interruptor (Listo); Q (Estado Puerta); Display (‘L’, ‘A’, ‘C’, ‘E’); Abrir; Cerrar

Figura 1: Diagrama de bloques funcional y conexionado en cascada.

—

### 3. Módulo 1: Decodificador de Contraseñas (Diseño y Reducción)

### 3.1. Codificación de Claves en Base 5

Las contraseñas se componen de 3 dígitos en base 5 (0 . . . 4), donde cada dígito se codifica en 3 bits binarios (P2P1P0). Las claves asignadas al sistema son:

Apertura (4135): Dígito 4 (100), Dígito 1 (001), Dígito 3 (011) =⇒ 011 001 1002.

Cierre (1425): Dígito 1 (001), Dígito 4 (100), Dígito 2 (010) =⇒ 010 100 0012.

### 3.2. Deducción Booleana y Reducción por Término Común

Las funciones lógicas canónicas requerirían dos redes independientes de 9 variables:

Abrir = P8 · P7 · P6 · P5 · P4 · P3 · P2 · P1 · P0 | (1)
Cerrar = P8 · P7 · P6 · P5 · P4 · P3 · P2 · P1 · P0 | (2)

La Tabla 1 analiza la correlación posicional entre ambas funciones para extraer redundancias lógicas:

Variable | P8 | P7 | P6 | P5 | P4 | P3 | P2 | P1 | P0
Abrir | 0 | 1 | 1 | 0 | 0 | 1 | 1 | 0 | 0
Cerrar | 0 | 1 | 0 | 1 | 0 | 0 | 0 | 0 | 1
Coincidencia | 0 | 1 | ̸= | ̸= | 0 | ̸= | ̸= | 0 | ̸=

Tabla 1: Identificación posicional de literales comunes.

Se extrae el factor común algebraico denominado COMUN:

COMUN = P8 · P4 · P1 · P7 | (3)

Aplicando el teorema de De Morgan sobre las variables complementadas:

P8 · P4 · P1 = P8 + P4 + P1 | (4)

Esta reducción permite sintetizar el término común empleando una compuerta NOR de tres entradas conectada a una compuerta AND:

COMUN = (P8 + P4 + P1) · P7 | (5)

Las expresiones mínimas que gobiernan las salidas del decodificador son:

Abrir = COMUN · (P6 · P5 · P3 · P2 · P0) | (6)
Cerrar = COMUN · (P6 · P5 · P3 · P2 · P0) | (7)

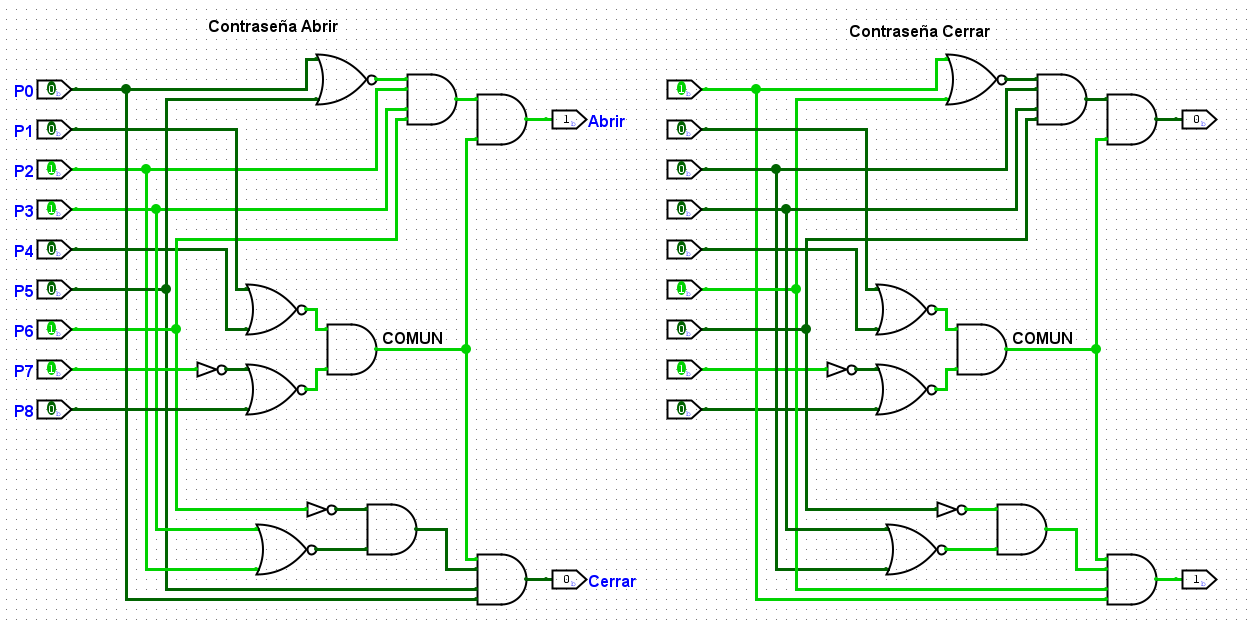
[picture p8: figure]

Figura 2: Esquemático del decodificador de claves optimizado.

### 4. Módulo 2: Decodificador de Apertura/Cierre y Retención (En Cascada)

### 4.1. Estructura del Latch SR

Las líneas Abrir y Cerrar generadas por el Módulo 1 se introducen en cascada a un Latch SR construido con compuertas NOR discretas:

Qt+1 = R + Qt

, | Qt+1 = S + Qt | (8)

Donde la señal Abrir excita la entrada Set (S) y la señal Cerrar excita la entrada Reset (R).

### 4.2. Exclusión de la Condición Crítica Indeterminada

La condición S = 1 y R = 1 representa el estado no permitido de un Latch SR. En esta arquitectura, **dicha condición queda excluida a nivel de diseño lógico**, dado que las combinaciones requeridas para activar Abrir (4135) y Cerrar (1425) son mutuamente excluyentes; no existe vector en las entradas P8 . . . P0 que satisfaga simultáneamente ambas ecuaciones booleanas.

S (Abrir) R (Cerrar) Qt+1 | Estado de la Puerta
0 | 0 | Qt | Retención de estado (Memoria)
1 | 0 | 1 | Puerta Abierta
0 | 1 | 0 | Puerta Cerrada
1 | 1 | — | Condición excluida por mutua exclusión de claves

Tabla 2: Tabla de transiciones del módulo de retención.

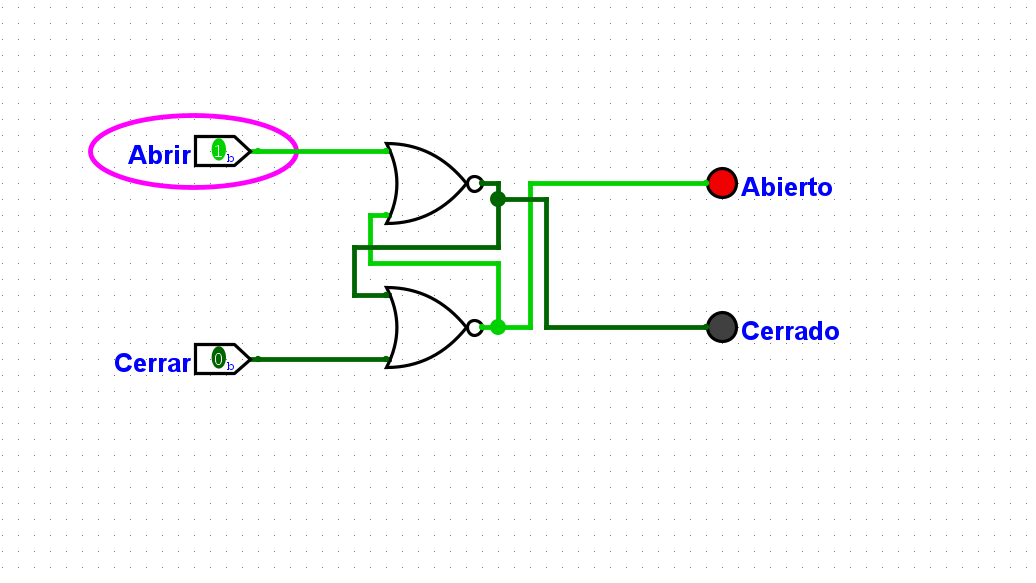
[picture p9: figure]

Figura 3: Implementación del circuito de retención.

### 5. Módulo 3: Decodificador de Anuncios (Display 7 Segmentos)

### 5.1. Tabla de Verdad y Estados Intermedios

El sistema traduce el estado de lectura y validación en cuatro caracteres intuitivos sobre un visualizador de cátodo común:

Leyendo (‘L’): Listo = 0.

Abriendo (‘A’): Listo = 1, Abrir = 1, Cerrar = 0.

Cerrando (‘C’): Listo = 1, Abrir = 0, Cerrar = 1.

Inválida (‘E’): Listo = 1, Abrir = 0, Cerrar = 0.

Para simplificar la síntesis, se establecen tres variables de estado intermedias (SA, SC, SE):

SA = Abrir · Listo | (9)
SC = Cerrar · Listo | (10)
SE = (Abrir + Cerrar) · Listo | (11)

La Tabla 3 demuestra que las señales SA, SC, SE se comportan como un código *one-hot* para los estados evaluados:

Estado | Carácter | Listo | Abrir | Cerrar | SA | SC | SE | a | b | c | d | e | f
g
Leyendo | L | 0 | X | X | 0 | 0 | 0 | 0 | 0 | 0 | 1 | 1 | 1
0
Abriendo | A | 1 | 1 | 0 | 1 | 0 | 0 | 1 | 1 | 1 | 0 | 1 | 1
1
Cerrando | C | 1 | 0 | 1 | 0 | 1 | 0 | 1 | 0 | 0 | 1 | 1 | 1
0
Inválida | E | 1 | 0 | 0 | 0 | 0 | 1 | 1 | 0 | 0 | 1 | 1 | 1
1

Tabla 3: Estados intermedios y mapeo hacia los segmentos del visualizador.

### 5.2. Ecuaciones de Segmentos y Justificación de Conexiones Estáticas

A partir de la Tabla 3, las ecuaciones booleanas de cada segmento se simplifican analíticamente:

Segmentos e y f (Conexión directa a VDD): Para los cuatro caracteres requeridos (‘L’, ‘A’, ‘C’, ‘E’), las funciones lógicas de los segmentos e y f se reducen a la constante lógica 1:

e = 1 (VDD), | f = 1 (VDD) | (12)

Justificación: Al tratarse de una función constante, no es necesaria una red de compuertas para implementarla..

Segmentos b y c: Operan exclusivamente en el estado Abriendo:

b = SA, | c = SA | (13)

Segmento d: Activo en todos los estados salvo en ‘A’:

d = SA | (14)

Segmento g: Activo en las combinaciones ‘A’ y ‘E’:

g = SA + SE | (15)

Segmento a: Activo durante la finalización de lectura (‘A’, ‘C’, ‘E’):

a = SA + SC + SE | (16)

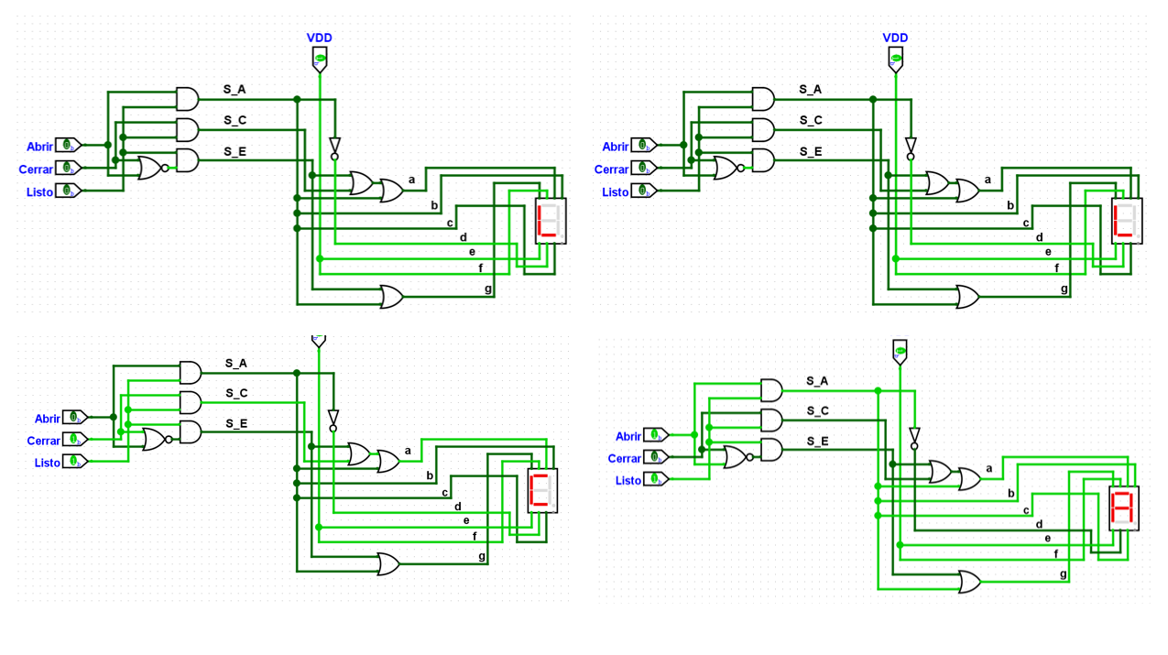
[picture p10: figure]

Figura 4: Circuito del decodificador de 7 segmentos optimizado.

### 6. Protocolo Experimental: Verificación por Separado e Integrada

En cumplimiento estricto con la especificación de probar los bloques por separado, se ejecutaron cuatro bancos de pruebas independientes.

### 6.1. Prueba 1: Verificación Aislada del Decodificador de Contraseñas

Se aplicaron vectores de prueba en los interruptores P8 . . . P0 sin conectar las salidas al resto del circuito. Para garantizar que el discriminador no presente falsos positivos, se evaluaron las claves válidas, combinaciones nulas y combinaciones críticas con distancia de Hamming de 1 bit respecto a las claves verdaderas (Tabla 4).

Descripción del Vector | Entrada (P8 . . . P0) Abrir | Cerrar | Resultado Observado
Clave Apertura Válida (4135) | 011001100 | 1 | 0 | Apertura detectada
Clave Cierre Válida (1425) | 010100001 | 0 | 1 | Cierre detectado
Vector Nulo | 000000000 | 0 | 0 | Rechazo correcto
Vector Saturado | 111111111 | 0 | 0 | Rechazo correcto
Error de 1 bit en Apertura (P0 = 1) | 011001101 | 0 | 0 | Rechazo correcto
Error de 1 bit en Cierre (P0 = 0) | 010100000 | 0 | 0 | Rechazo correcto

Tabla 4: Resultados de prueba independiente del decodificador de claves.

### 6.2. Prueba 2: Verificación Aislada del Latch de Retención

Desconectando las entradas del comparador de claves, se aplicaron pulsos lógicos directos sobre las terminales S y R del biestable, verificando la memoria de estado:

Secuencia | Entrada S | Entrada R | Salida Q | Comportamiento
1 | 0 | 0 | 0 | Mantiene estado inicial en bajo
2 | 1 | 0 | 1 | Transición a nivel alto (Set)
3 | 0 | 0 | 1 | Retención correcta tras retirar Set
4 | 0 | 1 | 0 | Transición a nivel bajo (Reset)
5 | 0 | 0 | 0 | Retención correcta tras retirar Reset

Tabla 5: Resultados de prueba independiente del Latch SR.

### 6.3. Prueba 3: Verificación Aislada del Decodificador de Anuncios

Se aislaron las entradas Listo, Abrir y Cerrar excitándolas manualmente para validar la síntesis de cada carácter en el display:

Listo | Abrir | Cerrar | Segmentos Encendidos | Carácter | Significado
0 | 0 | 0 | d, e, f | L | Modo Lectura
0 | 1 | 0 | d, e, f | L | Bloqueado (Lectura en curso)
1 | 1 | 0 | a, b, c, e, f, g | A | Abriendo Puerta
1 | 0 | 1 | a, d, e, f | C | Cerrando Puerta
1 | 0 | 0 | a, d, e, f, g | E | Contraseña Inválida

Tabla 6: Resultados de prueba independiente del decodificador de 7 segmentos.

### 6.4. Prueba 4: Integración en Cascada del Sistema Completo

Una vez verificados los tres bloques por separado, se conectó el sistema en cascada conforme a la Figura 1. Se evaluó el ciclo operacional completo:

Condición de Operación | Entrada (P8 . . . P0) Listo | Latch (Q) Display | Diagnóstico
Ingreso de clave en proceso | 011001100 | 0 | 0 | L | Lectura retenida
Confirmación de Apertura | 011001100 | 1 | 1 | A | Apertura exitosa
Retención post-apertura | Arbitraria | 0 | 1 | L | Estado Q = 1 preservado
Intento con clave errónea | 011001101 | 1 | 1 | E | Rechazo sin alterar Latch
Confirmación de Cierre | 010100001 | 1 | 0 | C | Cierre exitoso

Tabla 7: Prueba del sistema completo interconectado en cascada.

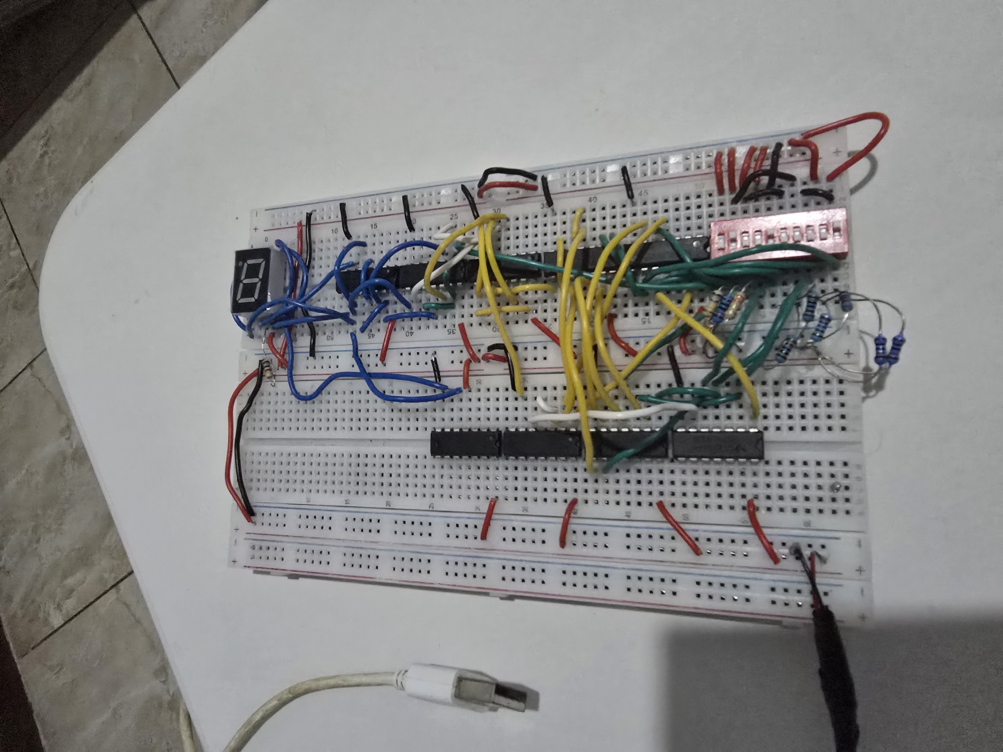
[picture p11: figure]

Figura 5: Evidencia del circuito implementado.

### 7. Conclusiones

1. La extracción del término común COMUN = (P8 + P4 + P1)·P7 mediante el teorema de De Morgan permitió sintetizar un único bloque discriminante para los 4 bits compartidos entre contraseñas, simplificando la topología de interconexión del comparador.
2. La exclusión de la condición indeterminada (S = 1, R = 1) del Latch SR se garantiza a nivel de arquitectura combinacional debido a la naturaleza mutuamente excluyente de las claves de apertura (4135) y cierre (1425).
3. La generación de estados intermedios (SA, SC, SE) demostró ser una técnica eficaz para desacoplar la lógica de control del mapeo físico de los segmentos, permitiendo reducir las salidas e y f a constantes lógicas directas a VDD sin comprometer la disciplina de diseño.
4. El protocolo experimental por separado evidenció la robustez de cada módulo ante vectores de entrada críticos (variaciones de 1 bit y entradas incompletas), validando la estabilidad funcional previa a la integración con el bus serial.
