Andy0122/CE1107-Cerrojo-Logico/(list of files, drawings)

Other design files:
sim/cerrojo_logica.circ
