Andy0122/CE1107-Cerrojo-Logico/(commit log)

2026-09-09 feat(sim): implement canonical open and close decoders with discrete AND/NOT gates
    [cerrojo_logica.circ]
2026-09-11 feat(sim): add discrete NOR latch module for door state retention
    [cerrojo_logica.circ]
2026-09-14 feat(sim): implement 7-segment display decoder with formal truth table and one-hot states
    [cerrojo_logica.circ]
2026-09-15 refactor(logic): optimize key decoders using De Morgan NOR-AND architecture without inverters
    [cerrojo_logica.circ]
2026-09-18 feat(input): add 4-finger LDR encoder subcircuit using XOR tree parity and bitwise logic
    [cerrojo_logica.circ]
2026-09-19 feat(serial): implement 3-bit parallel-to-serial MUX with 74LS153 and synchronous mod-3 counter
    [cerrojo_logica.circ]
2026-09-22 feat(receiver): separate 9-bit shift register data path from 'Listo' control counter
    [cerrojo_logica.circ]
2026-09-23 feat(power): implement galvanic optocoupled decoupling with PC817 and active-low L9110S driver
2026-09-26 feat(hardware): add complete BOM component table, NC limit-switch wiring and 10uF RC debouncing
2026-09-29 Se añade el paper a la documentación del proyecto.
2026-09-29 Error en el nombre del paper.
2026-09-30 Se añade la bitácora de trabajo del proyecto.
